sensestage/minibee_hardware/README

This repository contains the Eagle design files for the Sense/Stage MiniBee (folder minibee) and a programmer (folder programmer) for the Sense/Stage MiniBee.
