sensestage/minibee_hardware/minibee/revF_kicad/MiniBee_revF_BOM.ods

Sheet: MiniBee_BOM
MINIBEE REV. F
Item # | Qty | Ref Des | Manufacturer | Manufacturer part no | Farnell part no | DigiKey Part No. | Description | Package | Type |  |  | digikey price | farnell price | digikey total | farnell total
1 | 2 | C1, C2 | Multicomp | MC0805X106K100CT | 2320859 | 490-3332-1-ND (no longer available) | 10uF | CAP0805 | smt |  | SMD Multilayer Ceramic Capacitor, 0805 [2012 Metric], 10 µF, 10 V, ± 10%, X5R, MC Series | € 0,07 | € 0,04 | € 0,14 | € 0,08
2 | 3 | C3, C4, C5 | TDK Corporation | C1005X5R0J104K050BA | see below | 445-1266-1-ND | 0.1uF | CAP0402 | smt |  | 0.10µF ±10% 6.3V Ceramic Capacitor X5R 0402 (1005 Metric) | € 0,02 | € 0,00 | € 0,05 | € 0,01
3 | 1 | COINCELL |  |  |  | 1054KCT-ND | COINCELL | KEYSTONE_BATTERY_HOLDER | smt | DNS
4 | 1 | F1 | Bell Fuse Inc | 0ZCJ0050AF2E | see below | 507-1803-1-ND | PTCSMD | PTCSMD | smt |  | PTC RESTTBLE 0.50A 24V CHIP 1206 | € 0,14 | € 0,13 | € 0,14 | € 0,13
5 | 1 | IC1 | Atmel | ATMEGA328P-AU | 2425124 | ATMEGA328P-AU-ND | ATMEGA328P | TQFP32-08 | smt |  |  | € 1,75 | € 2,46 | € 1,75 | € 2,46
6 | 1 | JP1 |  |  |  |  | PINHD-2X10 |  | pinhead | DNS
7 | 2 | JP2, JP6 |  |  |  |  | PINHD-1X2 |  | pinhead | DNS
8 | 4 | JP3, JP4, JP5, JP7 |  |  |  |  | PINHD-1X1 |  | pinhead | DNS
9 | 1 | JST_CONNECTOR12 | JST | S2B-PH-SM4-TB(LF)(SN) | 9492615 | 455-1749-1-ND | Battery connector | M02-JST-2MM-SMT | smt |  |  | € 0,40 | € 0,38 | € 0,40 | € 0,38
10 | 1 | LED1 | Panasonic | LNJ326W83RA | 1699415 | P13485CT-ND | green | LED-0603 | smt |  | Green 572nm LED Indication - Discrete 2.05V 0603 (1608 Metric) | € 0,19 | € 0,22 | € 0,19 | € 0,22
11 | 1 | LED2 | Panasonic | LNJ237W82RA | 1908052 | LNJ237W82RACT-ND | red | LED-0603 | smt |  | LED, Red, SMD, 0.8mm x 1.1mm, 5 mA, 1.95 V, 630 nm | € 0,19 | € 0,18 | € 0,19 | € 0,18
12 | 1 | LED3 | Panasonic | LNJ826W86RA | 1908049 | P13486CT-ND | orange | LED-0603 | smt |  | LED, Orange, SMD, 0.8mm x 1.1mm, 5 mA, 1.92 V, 605 nm | € 0,22 | € 0,16 | € 0,22 | € 0,16
13 | 1 | LED4 | Panasonic | LNJ326W83RA | 1699415 | P13485CT-ND | blue (but actually green) | LED-0603 | smt |  |  | € 0,19 | € 0,22 | € 0,19 | € 0,22
14 | 4 | R1, R2, R3, R7 | Vishay | CRCW0402470RFKEDHP | 1738845 | 541-2938-1-ND | 470 Ohm | RESISTOR0402 | smt |  | SMD Chip Resistor, 470 ohm, 50 V, 0402 [1005 Metric], 125 mW, ± 1%, CRCW Series | € 0,05 | € 0,03 | € 0,19 | € 0,10
15 | 2 | R4, R5 | Yageo | RC0402JR-071KL |  | 311-1.0KJRCT-ND | 1kOhm | RESISTOR0402 | smt |  | RES SMD 1K OHM 5% 1/16W 0402 | € 0,00 |  | € 0,01 | € 0,00
16 | 1 | R6 | Yageo | RC0402JR-0710KL | see below | 311-10KJRCT-ND | 10kOhm | RESISTOR0402 | smt |  | RES SMD 10K OHM 5% 1/16W 0402 | € 0,00 | € 0,01 | € 0,00 | € 0,01
17 | 1 | RESONATOR12 | Murata | CSTCE12M0G55Z-R0 | 2470357 | 490-1220-1-ND | 12MHz | RESONATORSMD | smt |  | CER RES 12.0000MHZ 33PF SMD | € 0,32 | € 0,21 | € 0,32 | € 0,21
18 | 1 | SW1 | Alps | STSSS2222 | 1123873 |  | On/off switch |  | throughhole |  | Slide Switch, DPDT, Through Hole, STSS2 Series, 3 A |  | € 0,99 | € 0,00 | € 0,99
19 | 1 | U1 | Analog devices | ADXL345BCCZ | 1853935 | ADXL345BCCZ-RLCT-ND | accelerometer | LGA14 | smt |  |  | € 5,64 | € 4,52 | € 5,64 | € 4,52
20 | 1 | VREG12 | Microchip | MCP1755T-3302E/OT | 2361992 | MCP1755T-3302E/OTCT-ND | V_REG_LDOSMD | SOT23-5 | smt | 300 mA variant |  | € 0,39 | € 0,36 | € 0,39 | € 0,36
21 | 1 | XB1 |  |  |  |  | XBEE | XBEE | throughhole | DNS
22 | 2 | XB1 | Sullins Connector Solutions | NPPN101BFCN-RC | see below | S5751-10-ND | PINHD-10x1 female 2mm |  | throughhole | Replaces 21 | 10 Position Header Connector 0.079" (2.00mm) Through Hole Gold | € 0,72 | € 1,05 | € 1,45 | € 2,10
23 | 4 | JP8, JP9, JP10, JP11 |  |  |  |  |  | pad | smt | DNS
24 | 2 | JP12, JP13 |  |  |  |  |  | pad | smt | DNS
Alternative parts |  |  |  |  |  |  |  |  |  |  |  |  |  | € 11,27 | € 12,14
2 | 3 | C3, C4, C5 | Multicomp | MC0402X104K6R3CT | 2320773 |  | 0.1uF | CAP0402 | smt
4 | 1 | F1 | Multicomp | MC36214 | 1861181 |  | PTCSMD | PTCSMD | smt |  | PPTC Resettable Fuse, SMD, MC36 Series, 500 mA, 1 A, 16 VDC, -40 °C |  | € 0,13
16 | 1 | R6 | Yageo | RC0402JR-0710KL | 9232885 |  | 10kOhm | RESISTOR0402 | smt |  | SMD Chip Resistor, Thick Film, 10 kohm, 50 V, 0402 [1005 Metric], 62.5 mW, ± 5%, RC Series
22 | 2 | XB1 | Harwin | M22-7131042 | 1109732 |  | PINHD-10x1 female 2mm |  | throughhole | Replaces 21 | Board-To-Board Connector, Vertical, 2 mm, 10 Contacts, Receptacle, M22 Series, Through Hole, 1 Rows |  | € 1,05
No solder paste on bottom

Sheet: Sheet2
20 | 1 | VREG | Microchip | MIC5205-3.3YM5-TR | 2510222 | 576-1259-1-ND | V_REG_LDOSMD | SOT23-5 | smt | 150 mA | 0,309 | 0,269 | 0,309 | 0,269
