sensestage/minibee_hardware/minibee/revF_kicad/modified_eagle_files/MiniBee.brd

## EAGLE design minibee/revF_kicad/modified_eagle_files/MiniBee.brd (2017-01-17)

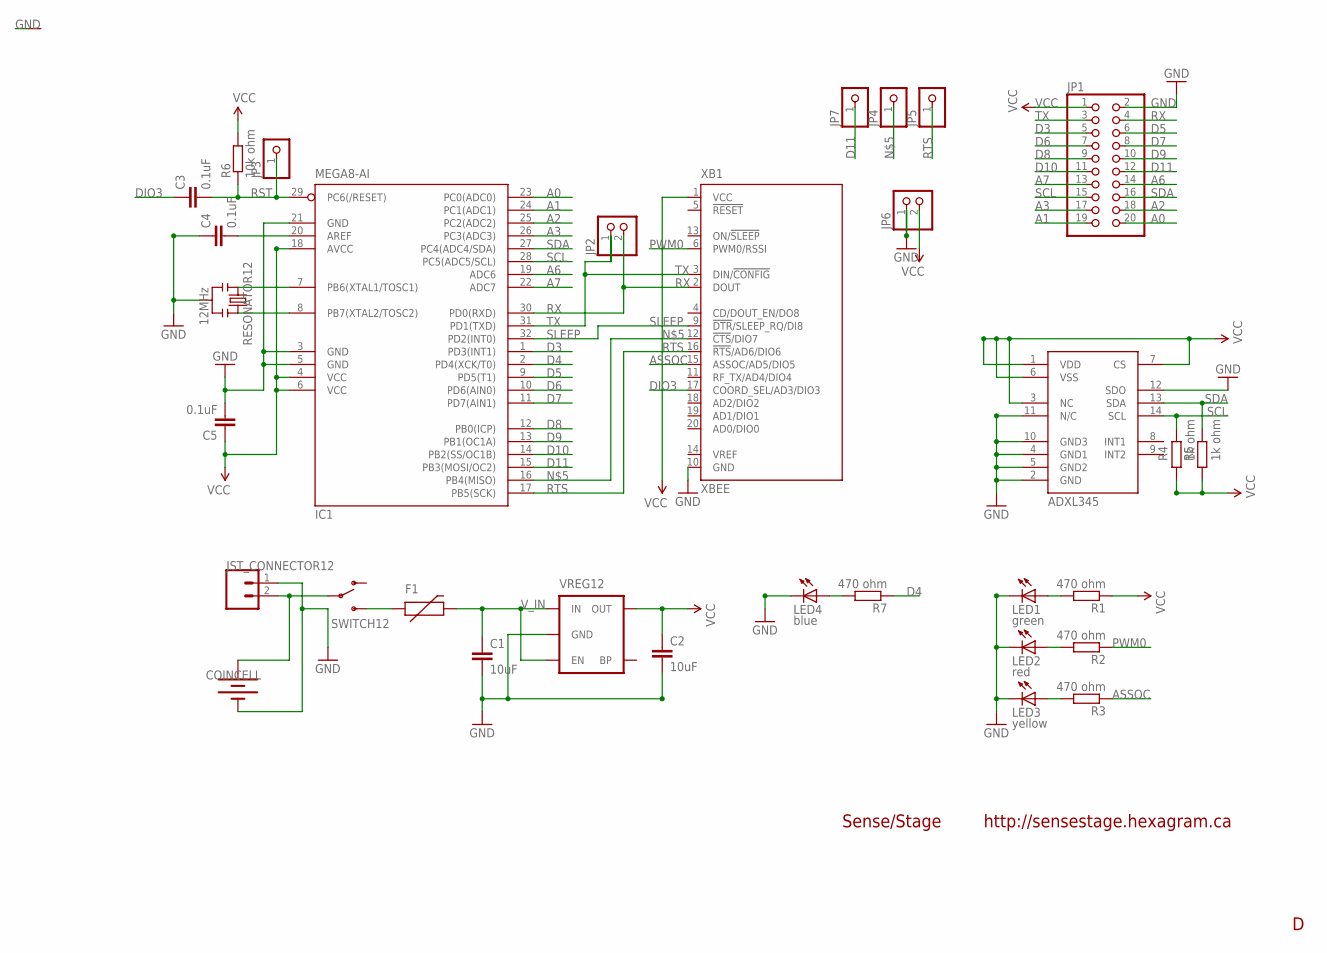
[picture p2: schematic MiniBee.sch]

Parts:
C1, C2: 10uF; C0805
C3, C4: 0.1uF; C0402
C5: 0.1uF; C0402K
COINCELL12: COINCELL; KEYSTONE_BATTERY_HOLDER
F1: PTCSMD; PTC-1206
IC1: MEGA8-AI; TQFP32-08
JP1: PINHD-2X10; 2X10
JP2, JP6: PINHD-1X2; 1X02
JP3, JP4, JP5, JP7: PINHD-1X1; 1X01
JST_CONNECTOR12: JST_CONNECTOR; S2B-PH
LED1: green; CHIP-LED0603
LED2: red; CHIP-LED0603
LED3: yellow; CHIP-LED0603
LED4: blue; CHIP-LED0603
R1, R2, R3, R7: 470 ohm; R0402
R4, R5: 1k ohm; R0402
R6: 10k ohm; R0402
RESONATOR12: 12MHz; RESONATOR-SMD
SWITCH12: MYSHIT_PCM_SWITCH; MYSHIT_PCM_SWITCH_RA
U1: ADXL345; LGA14
VP_0: VPDEV0; VPAC0
VREG12: V_REG_LDOSMD; SOT23-5
XB1: XBEE

Connections:
A0: IC1.23 (PC0(ADC0)), JP1.20
A1: IC1.24 (PC1(ADC1)), JP1.19
A2: IC1.25 (PC2(ADC2)), JP1.18
A3: IC1.26 (PC3(ADC3)), JP1.17
A6: IC1.19 (ADC6), JP1.14
A7: IC1.22 (ADC7), JP1.13
ASSOC: R3.1, XB1.15 (ASSOC/AD5/DIO5)
D3: IC1.1 (PD3(INT1)), JP1.5
D4: IC1.2 (PD4(XCK/T0)), R7.1
D5: IC1.9 (PD5(T1)), JP1.6
D6: IC1.10 (PD6(AIN0)), JP1.7
D7: IC1.11 (PD7(AIN1)), JP1.8
D8: IC1.12 (PB0(ICP)), JP1.9
D9: IC1.13 (PB1(OC1A)), JP1.10
D10: IC1.14 (PB2(SS/OC1B)), JP1.11
D11: IC1.15 (PB3(MOSI/OC2)), JP1.12, JP7.1
DIO3: C3.1, XB1.17 (COORD_SEL/AD3/DIO3)
GND: C1.2, C2.2, C4.1, C5.2, COINCELL12.-, IC1.3 (GND), IC1.5 (GND), IC1.21 (GND), JP1.2, JP6.1, JST_CONNECTOR12.1, LED1.C, LED2.C, LED3.C, LED4.C, RESONATOR12.2, U1.2 (GND), U1.4 (GND1), U1.5 (GND2), U1.10 (GND3), U1.11 (N/C), U1.12 (SDO), VP_0.VP, VREG12.2 (GND), XB1.10 (GND)
unnamed: IC1.7 (PB6(XTAL1/TOSC1)), RESONATOR12.1
unnamed: IC1.8 (PB7(XTAL2/TOSC2)), RESONATOR12.3
unnamed: LED1.A, R1.2
unnamed: COINCELL12.+, JST_CONNECTOR12.2, SWITCH12.2
unnamed: IC1.16 (PB4(MISO)), JP4.1, XB1.12 (!CTS!/DIO7)
unnamed: LED2.A, R2.2
unnamed: LED3.A, R3.2
unnamed: F1.1, SWITCH12.3 (S)
unnamed: C4.2, IC1.20 (AREF)
unnamed: LED4.A, R7.2
PWM0: R2.1, XB1.6 (PWM0/RSSI)
RST: C3.2, IC1.29 (PC6(/RESET)), JP3.1, R6.1
RTS: IC1.17 (PB5(SCK)), JP5.1, XB1.16 (!RTS!/AD6/DIO6)
RX: IC1.30 (PD0(RXD)), JP1.4, JP2.2, XB1.2 (DOUT)
SCL: IC1.28 (PC5(ADC5/SCL)), JP1.15, R4.2, U1.14 (SCL)
SDA: IC1.27 (PC4(ADC4/SDA)), JP1.16, R5.2, U1.13 (SDA)
SLEEP: IC1.32 (PD2(INT0)), XB1.9 (!DTR!/SLEEP_RQ/DI8)
TX: IC1.31 (PD1(TXD)), JP1.3, JP2.1, XB1.3 (DIN/!CONFIG)
VCC: C2.1, C5.1, IC1.4 (VCC), IC1.6 (VCC), IC1.18 (AVCC), JP1.1, JP6.2, R1.1, R4.1, R5.1, R6.2, U1.1 (VDD), U1.3 (NC), U1.6 (VSS), U1.7 (CS), VREG12.5 (OUT), XB1.1 (VCC)
V_IN: C1.1, F1.2, VREG12.1 (IN), VREG12.3 (EN)

Notes on the sheet:
Sense/Stage
http://sensestage.hexagram.ca

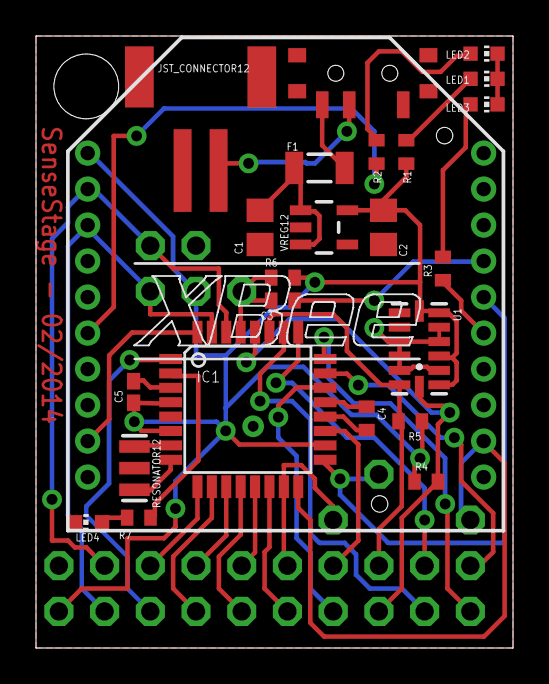
[picture p3: board MiniBee.brd from above]

Board: 2 copper layers, 26.5 x 34.0 mm, 33 parts (1 on the bottom side), 38 nets.
