sensestage/minibee_hardware/(commit log)

2010-11-18 add the revision C eagle files
    [MiniBee.brd, MiniBee.sch]
2010-11-18 added breakout pins for programmer for D11 and GND and Vcc (3v3)
    [MiniBee.brd, MiniBee.sch]
2011-01-11 updates to the board - routing all the wires to the new pins
    [MiniBee.brd, MiniBee.sch]
2011-01-11 fixed the font thickness and added some labels
    [MiniBee.brd]
2011-01-11 gerber files for the MiniBee
2011-01-17 i2c envir files, and drill file for MiniBee board.
2011-01-17 more directory cleanup actions.
    [MiniBee.brd, MiniBee.sch]
2011-02-08 Start of a revision E. Uses SMD footprint headers and a different coincell holder. Also features an 8-pin programming header. Resulting in a bigger board, though routing is still tricky. Not finished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
    [MiniBee.brd, MiniBee.sch]
2011-02-08 minor changes
    [MiniBee.brd, MiniBee.sch]
2011-02-08 fix some routes
    [MiniBee.brd]
2011-04-07 switch around GND/3v3 and RX/TX so board is more compatible with revB.
    [MiniBee.brd, MiniBee.sch]
2011-04-08 cleanup of some traces and vias; moved the ME led a bit.
    [MiniBee.brd, MiniBee_revD_BOM.xls]
2011-04-13 added one more via between ground planes.
    [MiniBee.brd, MiniBee_revD_BOM.xls]
2011-05-09 programmer board for MiniBee revD
    [MiniBeeProgrammer.brd, MiniBeeProgrammer.sch]
2011-05-09 updates to the board with layers with the component orientation
    [MiniBee.brd, MiniBee.sch, MiniBee_revD_BOM.xls]
2011-05-11 adjusted board to olimex specs, and added the design rules from them
    [MiniBeeProgrammer.brd]
2011-06-20 update to programmer board
    [MiniBeeProgrammer.brd, MiniBeeProgrammer.sch]
2011-06-22 update to MiniBee board (show all layers), and fix BOM.
    [MiniBee.brd, MiniBee_revD_BOM.xls]
2011-08-26 updates to the programmer - still have to double check the new hole positions with XPlorer board
    [MiniBeeProgrammer.brd, MiniBeeProgrammer.sch]
2012-08-14 reorganise directories
    [MiniBee.brd, MiniBee.sch, MiniBeeProgrammer.brd, MiniBeeProgrammer.sch, MiniBee_revD_BOM.xls]
2013-06-12 add revA for historical purposes
    [MiniBee.brd, MiniBee.sch]
2013-07-04 raspberry pi xbee coordinator shield
    [pi_coordinator.brd, pi_coordinator.sch]
2014-02-21 updates to the board based on feedback from manufacturer
    [MiniBee.brd, MiniBee.sch]
2017-01-17 kicad conversion and fixes of revD board
    [MiniBee.brd, MiniBee.kicad_pcb, MiniBee.sch]
2017-01-17 gerber files for modified revD
    [MiniBee-B.Adhes.gbr, MiniBee-B.CrtYd.gbr, MiniBee-B.Fab.gbr, MiniBee-B.Mask.gbr, MiniBee-B.Paste.gbr, MiniBee-B.SilkS.gbr, MiniBee-Bottom.gbr, MiniBee-Edge.Cuts.gbr]
2017-01-17 updates to board: exchanged D2 and D7, other switch
    [MiniBee.kicad_pcb, MiniBee.sch]
2017-01-17 switch footprint, updated BOM
    [MiniBee_revD_BOM_alternatives.ods]
2017-01-17 updated gerbers for revision F
    [MiniBee-B.Adhes.gbr, MiniBee-B.CrtYd.gbr, MiniBee-B.Fab.gbr, MiniBee-B.Mask.gbr, MiniBee-B.Paste.gbr, MiniBee-B.SilkS.gbr, MiniBee-Bottom.gbr, MiniBee-Edge.Cuts.gbr]
2017-01-17 update silkscreen to rev F
    [MiniBee-B.Adhes.gbr, MiniBee-B.CrtYd.gbr, MiniBee-B.Fab.gbr, MiniBee-B.Mask.gbr, MiniBee-B.Paste.gbr, MiniBee-B.SilkS.gbr, MiniBee-Bottom.gbr, MiniBee-Edge.Cuts.gbr]
2017-01-18 rename BOM
    [MiniBee_revF_BOM.ods]
2017-01-18 update board
    [MiniBee-B.Adhes.gbr, MiniBee-B.CrtYd.gbr, MiniBee-B.Fab.gbr, MiniBee-B.Mask.gbr, MiniBee-B.Paste.gbr, MiniBee-B.SilkS.gbr, MiniBee-Bottom.gbr, MiniBee-Edge.Cuts.gbr]
2017-01-18 update BOM
    [MiniBee_revF_BOM.ods]
2017-02-07 fix some traces (mostly the Vcc trace that was close to the edge)
    [MiniBee-B.Adhes.gbr, MiniBee-B.CrtYd.gbr, MiniBee-B.Fab.gbr, MiniBee-B.Mask.gbr, MiniBee-B.Paste.gbr, MiniBee-B.SilkS.gbr, MiniBee-Bottom.gbr, MiniBee-Edge.Cuts.gbr]
2019-05-11 additional files for rev F
    [MiniBee.sch]
